RobertWeber1/pico_edge/pico_edgy.kicad_pcb

## KiCad design pico_edgy.kicad_pcb (2024-10-25)

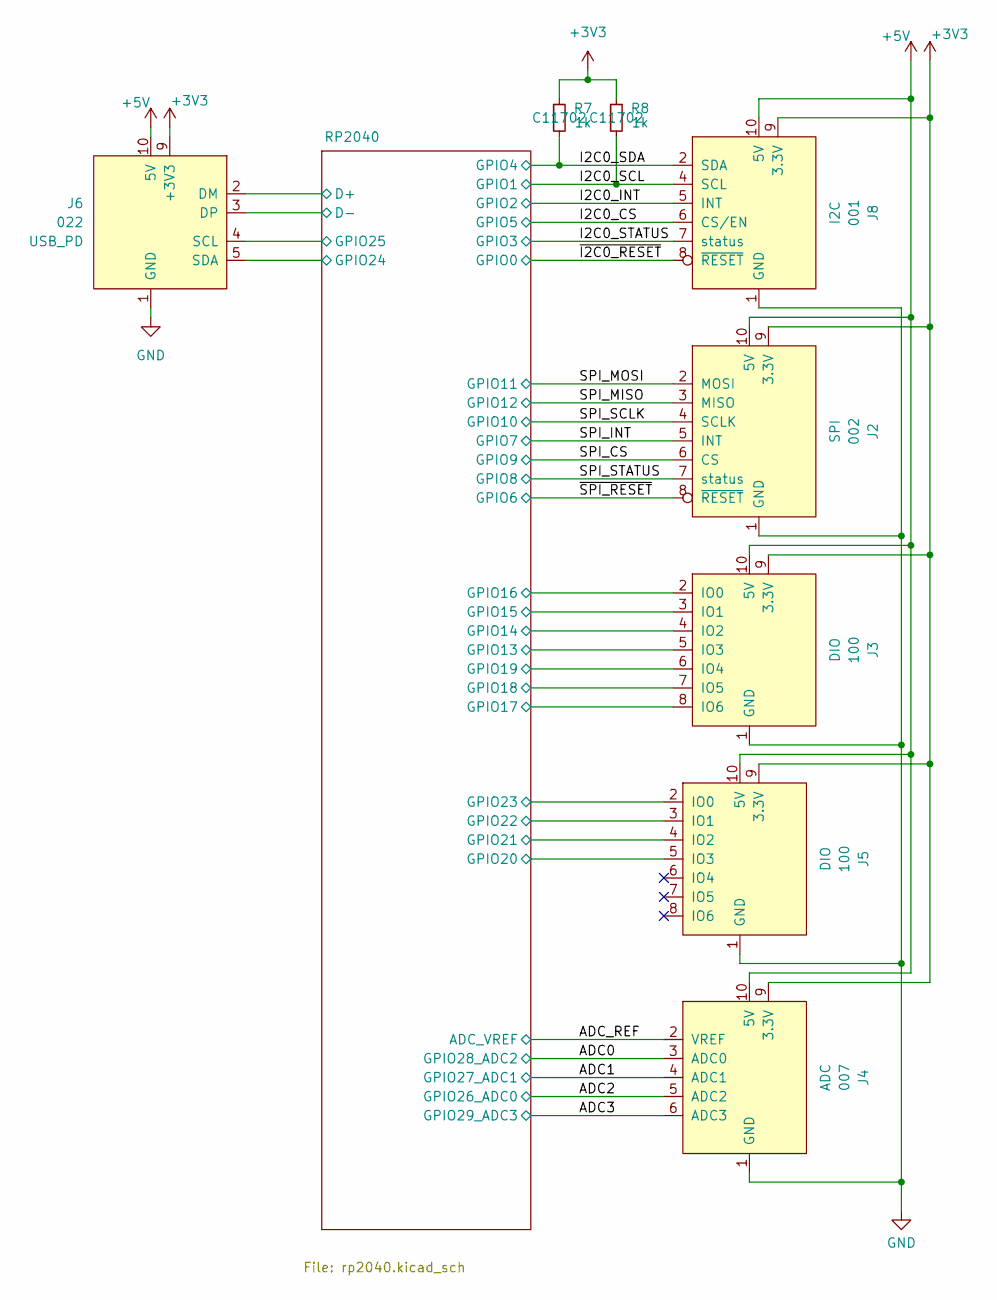
[picture p1: schematic pico_edgy.kicad_sch]

Parts:
J2: 002; on_edge_2x05_host
J3, J5: 100; on_edge_2x05_host
J4: 007; on_edge_2x05_host
J6: 022; on_edge_2x05_host
J8: 001; on_edge_2x05_host
R7, R8: 1k; R_0402_1005Metric; LCSC C25543

Connections:
+3V3: J2.9 (3.3V), J3.9 (3.3V), J4.9 (3.3V), J5.9 (3.3V), J6.9 (+3V3), J8.9 (3.3V), R7.1, R8.1; also elsewhere on the board
+5V: J2.10 (5V), J3.10 (5V), J4.10 (5V), J5.10 (5V), J6.10 (5V), J8.10 (5V)
/ADC0: J4.3 (ADC0); also elsewhere on the board
/ADC1: J4.4 (ADC1); also elsewhere on the board
/ADC2: J4.5 (ADC2); also elsewhere on the board
/ADC3: J4.6 (ADC3); also elsewhere on the board
/ADC_REF: J4.2 (VREF); also elsewhere on the board
/I2C0_CS: J8.6 (CS/EN); also elsewhere on the board
/I2C0_INT: J8.5 (INT); also elsewhere on the board
/I2C0_SCL: J8.4 (SCL), R8.2; also elsewhere on the board
/I2C0_SDA: J8.2 (SDA), R7.2; also elsewhere on the board
/I2C0_STATUS: J8.7 (status); also elsewhere on the board
/RP2040/D+: J6.2 (DM); also elsewhere on the board
/RP2040/D-: J6.3 (DP); also elsewhere on the board
/RP2040/GPIO13: J3.5 (IO3); also elsewhere on the board
/RP2040/GPIO14: J3.4 (IO2); also elsewhere on the board
/RP2040/GPIO15: J3.3 (IO1); also elsewhere on the board
/RP2040/GPIO16: J3.2 (IO0); also elsewhere on the board
/RP2040/GPIO17: J3.8 (IO6); also elsewhere on the board
/RP2040/GPIO18: J3.7 (IO5); also elsewhere on the board
/RP2040/GPIO19: J3.6 (IO4); also elsewhere on the board
/RP2040/GPIO20: J5.5 (IO3); also elsewhere on the board
/RP2040/GPIO21: J5.4 (IO2); also elsewhere on the board
/RP2040/GPIO22: J5.3 (IO1); also elsewhere on the board
/RP2040/GPIO23: J5.2 (IO0); also elsewhere on the board
/RP2040/GPIO24: J6.5 (SDA); also elsewhere on the board
/RP2040/GPIO25: J6.4 (SCL); also elsewhere on the board
/SPI_CS: J2.6 (CS); also elsewhere on the board
/SPI_INT: J2.5 (INT); also elsewhere on the board
/SPI_MISO: J2.3 (MISO); also elsewhere on the board
/SPI_MOSI: J2.2 (MOSI); also elsewhere on the board
/SPI_SCLK: J2.4 (SCLK); also elsewhere on the board
/SPI_STATUS: J2.7 (status); also elsewhere on the board
/~I2C0_RESET: J8.8 (~RESET); also elsewhere on the board
/~SPI_RESET: J2.8 (~RESET); also elsewhere on the board
GND: J2.1 (GND), J3.1 (GND), J4.1 (GND), J5.1 (GND), J6.1 (GND), J8.1 (GND); also elsewhere on the board

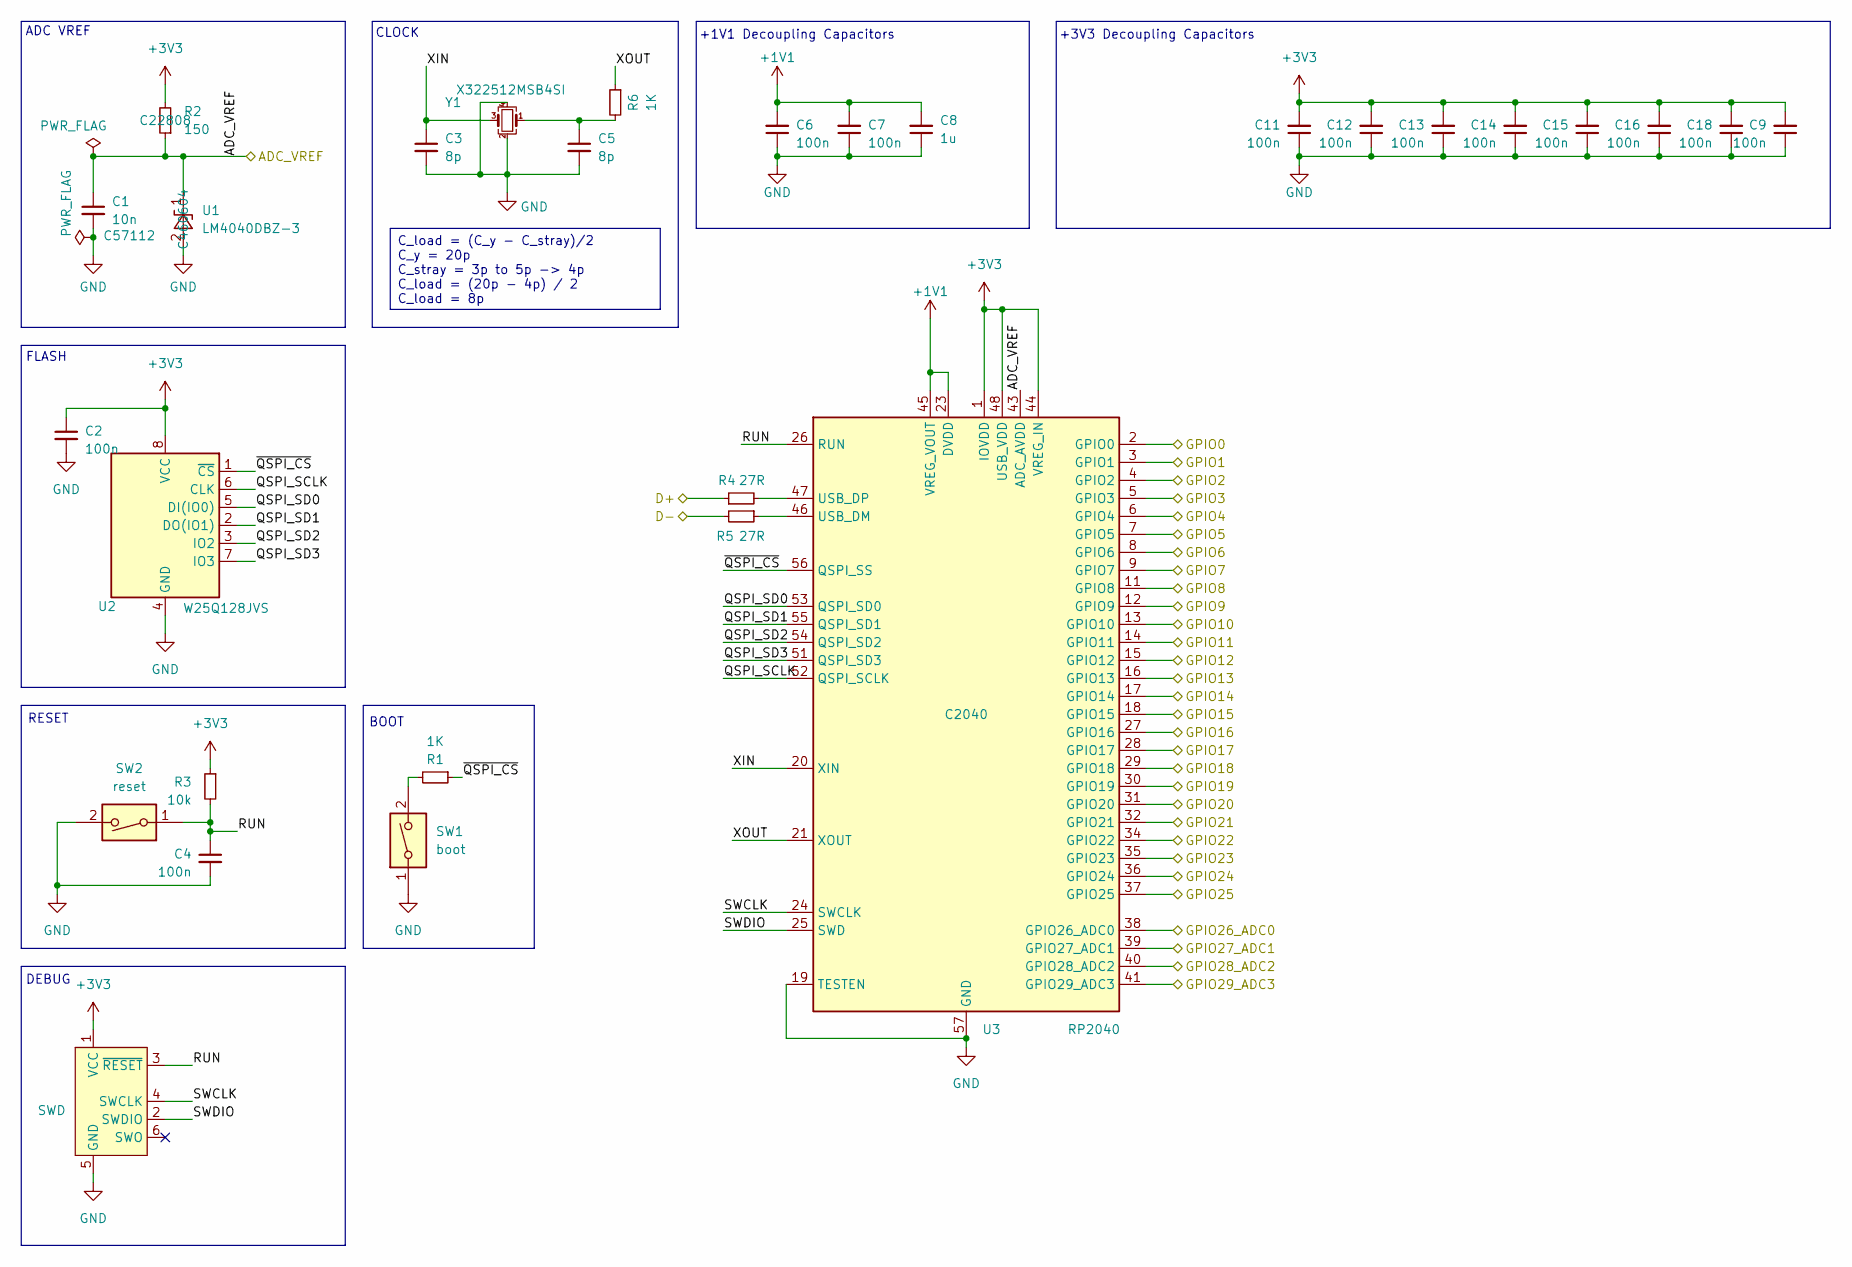
[picture p2: schematic rp2040.kicad_sch, Minimal RP2040]

Parts:
C1: 10n; C_0603_1608Metric_Pad1.08x0.95mm_HandSolder; LCSC C76599
C2, C4, C6, C7, C9, C11, C12, C13, C14, C15, C16, C18: 100n; C_0402_1005Metric_Pad0.74x0.62mm_HandSolder; LCSC Part# C307331
C3, C5: 8p; C_0402_1005Metric_Pad0.74x0.62mm_HandSolder; LCSC Part# C130118
C8: 1u; C_0402_1005Metric_Pad0.74x0.62mm_HandSolder; LCSC Part# C52923
J1: SWD; Tag-Connect_TC2030-IDC-NL_2x03_P1.27mm_Vertical
R1, R6: 1K; R_0402_1005Metric_Pad0.72x0.64mm_HandSolder; LCSC Part# C11702
R2: 150; R_0603_1608Metric_Pad0.98x0.95mm_HandSolder; LCSC C22808
R3: 10k; R_0402_1005Metric_Pad0.72x0.64mm_HandSolder; LCSC Part# C25744
R4, R5: 27R; R_0402_1005Metric_Pad0.72x0.64mm_HandSolder; LCSC Part# C140174
SW1: boot; SW_Push_1P1T_XKB_TS-1187A; LCSC Part# C318884
SW2: reset; SW_Push_1P1T_XKB_TS-1187A; LCSC Part# C318884
U1: LM4040DBZ-3; SOT-23; LCSC C460726
U2: W25Q128JVS; WSON-8-1EP_6x5mm_P1.27mm_EP3.4x4.3mm; LCSC Part# C190862
U3: RP2040; QFN-56-1EP_7x7mm_P0.4mm_EP3.2x3.2mm; LCSC Part# C2040
Y1: X322512MSB4SI; Crystal_SMD_3225-4Pin_3.2x2.5mm; LCSC Part# C9002

Connections:
+1V1: C6.2, C7.2, C8.2, U3.23 (DVDD), U3.45 (VREG_VOUT), U3.50 (DVDD)
+3V3: C2.1, C9.2, C11.2, C12.2, C13.2, C14.2, C15.2, C16.2, C18.2, J1.1 (VCC), R2.2, R3.1, U2.8 (VCC), U3.1 (IOVDD), U3.10 (IOVDD), U3.22 (IOVDD), U3.33 (IOVDD), U3.42 (IOVDD), U3.44 (VREG_IN), U3.48 (USB_VDD), U3.49 (IOVDD); also elsewhere on the board
/ADC0: U3.40 (GPIO28_ADC2); also elsewhere on the board
/ADC1: U3.39 (GPIO27_ADC1); also elsewhere on the board
/ADC2: U3.38 (GPIO26_ADC0); also elsewhere on the board
/ADC3: U3.41 (GPIO29_ADC3); also elsewhere on the board
/ADC_REF: C1.1, R2.1, U1.1 (K), U3.43 (ADC_AVDD); also elsewhere on the board
/I2C0_CS: U3.7 (GPIO5); also elsewhere on the board
/I2C0_INT: U3.4 (GPIO2); also elsewhere on the board
/I2C0_SCL: U3.3 (GPIO1); also elsewhere on the board
/I2C0_SDA: U3.6 (GPIO4); also elsewhere on the board
/I2C0_STATUS: U3.5 (GPIO3); also elsewhere on the board
/RP2040/D+: R4.1; also elsewhere on the board
/RP2040/D-: R5.2; also elsewhere on the board
/RP2040/GPIO13: U3.16 (GPIO13); also elsewhere on the board
/RP2040/GPIO14: U3.17 (GPIO14); also elsewhere on the board
/RP2040/GPIO15: U3.18 (GPIO15); also elsewhere on the board
/RP2040/GPIO16: U3.27 (GPIO16); also elsewhere on the board
/RP2040/GPIO17: U3.28 (GPIO17); also elsewhere on the board
/RP2040/GPIO18: U3.29 (GPIO18); also elsewhere on the board
/RP2040/GPIO19: U3.30 (GPIO19); also elsewhere on the board
/RP2040/GPIO20: U3.31 (GPIO20); also elsewhere on the board
/RP2040/GPIO21: U3.32 (GPIO21); also elsewhere on the board
/RP2040/GPIO22: U3.34 (GPIO22); also elsewhere on the board
/RP2040/GPIO23: U3.35 (GPIO23); also elsewhere on the board
/RP2040/GPIO24: U3.36 (GPIO24); also elsewhere on the board
/RP2040/GPIO25: U3.37 (GPIO25); also elsewhere on the board
/RP2040/QSPI_SCLK: U2.6 (CLK), U3.52 (QSPI_SCLK)
/RP2040/QSPI_SD0: U2.5 (DI(IO0)), U3.53 (QSPI_SD0)
/RP2040/QSPI_SD1: U2.2 (DO(IO1)), U3.55 (QSPI_SD1)
/RP2040/QSPI_SD2: U2.3 (IO2), U3.54 (QSPI_SD2)
/RP2040/QSPI_SD3: U2.7 (IO3), U3.51 (QSPI_SD3)
/RP2040/RUN: C4.1, J1.3 (~RESET), R3.2, SW2.1, U3.26 (RUN)
/RP2040/SWCLK: J1.4 (SWCLK), U3.24 (SWCLK)
/RP2040/SWDIO: J1.2 (SWDIO), U3.25 (SWD)
/RP2040/XIN: C3.1, U3.20 (XIN), Y1.3
/RP2040/XOUT: R6.1, U3.21 (XOUT)
/RP2040/~QSPI_CS: R1.1, U2.1 (~CS), U3.56 (QSPI_SS)
/SPI_CS: U3.12 (GPIO9); also elsewhere on the board
/SPI_INT: U3.9 (GPIO7); also elsewhere on the board
/SPI_MISO: U3.15 (GPIO12); also elsewhere on the board
/SPI_MOSI: U3.14 (GPIO11); also elsewhere on the board
/SPI_SCLK: U3.13 (GPIO10); also elsewhere on the board
/SPI_STATUS: U3.11 (GPIO8); also elsewhere on the board
/~I2C0_RESET: U3.2 (GPIO0); also elsewhere on the board
/~SPI_RESET: U3.8 (GPIO6); also elsewhere on the board
GND: C1.2, C2.2, C3.2, C4.2, C5.2, C6.1, C7.1, C8.1, C9.1, C11.1, C12.1, C13.1, C14.1, C15.1, C16.1, C18.1, J1.5 (GND), SW1.1, SW2.2, U1.2 (A), U2.4 (GND), U3.19 (TESTEN), U3.57 (GND), Y1.2, Y1.4; also elsewhere on the board
unnamed: C5.1, R6.2, Y1.1
unnamed: R1.2, SW1.2
unnamed: R5.1, U3.46 (USB_DM)
unnamed: R4.2, U3.47 (USB_DP)

Notes on the sheet:
FLASH
DEBUG
BOOT
RESET
CLOCK
+3V3 Decoupling Capacitors
ADC VREF
+1V1 Decoupling Capacitors
C_load = (C_y - C_stray)/2 C_y = 20p C_stray = 3p to 5p -> 4p C_load = (20p - 4p) / 2 C_load = 8p

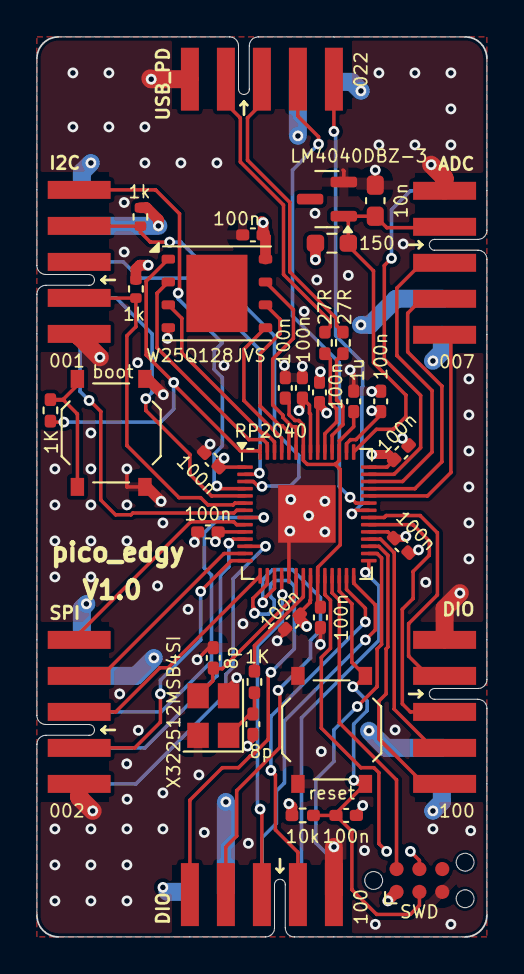
[picture p3: board pico_edgy.kicad_pcb from above]

Board: 4 copper layers, 25.0 x 50.0 mm, 37 parts (0 on the bottom side), 52 nets.
